greatscottgadgets/amalthea/(notices)

Notices in the files:
hardware/rev0/ram_section.sch:
Licensed under CERN-OHL-P version 2
hardware/rev0/luna_rev0.sch:
Licensed under the CERN OHL v1.2
